weijerry982-oss/esp32-codex-voice-terminal/docs/hardware.md

模块	GPIO 分配（参考图）

I²S 麦克风 WS	GPIO4

I²S 麦克风 SCK	GPIO5

I²S 麦克风 SD	GPIO6

MAX98357A DIN	GPIO7

MAX98357A BCLK	GPIO15

MAX98357A LRC	GPIO16

OLED SDA	GPIO41

OLED SCL	GPIO42
# ESP32-S3 N16R8 开发板与外设

开发板目标为 ESP32-S3 N16R8，Arduino IDE 开发板型号暂定 `ESP32S3 Dev Module`。Flash、PSRAM、USB 与其他编译参数应根据实物和阶段 1 验证结果确认。

## 外设清单

- I²S 麦克风：待确认具体型号及供电/电平要求。
- MAX98357A I²S 功放与扬声器：待确认扬声器规格及供电。
- OLED：0.91 英寸，128×32，I²C；控制器型号待确认。
- 实体按键：用途包括明确任务的确认/取消交互，接线和去抖方式待验证。
- 状态 LED：颜色、有效电平及限流配置待验证。

## 引脚表（用户确认接线；实物电气待验证）

上方保留了仓库原有参考清单。下表反映用户确认的接线图；实际板卡连通性与模块电气参数仍待实物核对。确认最终接线后依项目规则不得擅自更改。

| 模块/信号 | ESP32-S3 GPIO | 状态 |
| --- | --- | --- |
| I²S 麦克风 WS | GPIO4 | 接线图已确认；2026-10-18 I2S 录音验证通过；具体型号仍待核对 |
| I²S 麦克风 SCK | GPIO5 | 接线图已确认；2026-10-18 I2S 录音验证通过；具体型号仍待核对 |
| I²S 麦克风 SD | GPIO6 | 接线图已确认；2026-10-18 I2S 录音验证通过；具体型号仍待核对 |
| MAX98357A DIN | GPIO7 | 接线图已确认；实物待核对 |
| MAX98357A BCLK | GPIO15 | 接线图已确认；实物待核对 |
| MAX98357A LRC | GPIO16 | 接线图已确认；实物待核对 |
| OLED SDA | GPIO41 | 接线图已确认；2026-10-18 I²C 通信成功（地址 0x3C）；显示已目视确认 |
| OLED SCK（I²C 时钟；通常称 SCL） | GPIO42 | 接线图已确认；2026-10-18 I²C 通信成功；显示已目视确认 |
| 按键 A | GPIO39 | 外接微动按钮到 GND；INPUT_PULLUP，低电平有效；30 ms 去抖；阶段 7 SEND（发送 ChatGPT 草稿） |
| 按键 B | GPIO40 | 外接微动按钮到 GND；INPUT_PULLUP，低电平有效；30 ms 去抖；阶段 7 CLEAR（清空 ChatGPT 草稿） |
| 状态 RGB LED | GPIO48 | XL-5050RGBC-WS2812B（WS2812B 兼容，24-bit GRB）；阶段 7：录音绿灯、SEND 绿闪 2 次、CLEAR 黄闪 2 次；用户目视确认 RGB 正常 |

麦克风采音与功放播放需分别验证，再进行组合运行验证。不得依据本文宣称硬件已运行成功。

## 确认按钮安全边界

实体确认按钮只能批准设备界面当前明确展示的待确认任务，不得无条件批准所有操作。Codex CLI 自身的权限检查和审批机制必须保留，不得关闭。

## 用户提供的接线图确认（当前接线基准）

用户确认附件中的接线图是本项目正确接线。此表描述用户的外接模块接法，不据此推断为小智仓库某个特定成品板型。图中音频引脚与 `bread-compact-wifi-lcd` 的 I²S simplex 音频配置一致；显示屏则是另接的 I²C 模块，不能套用该板型内置 SPI LCD 的引脚解释。

| 模块/端子 | 接线 | 备注 |
| --- | --- | --- |
| I²S 麦克风 WS | GPIO4 | 图示兼容 INMP441 / ICS43434，具体型号待实物确认 |
| I²S 麦克风 SCK | GPIO5 | I²S 时钟 |
| I²S 麦克风 SD | GPIO6 | 麦克风数据输出 |
| 麦克风 VDD / GND | 3V3 / GND | 图示如此；模块实际供电要求待核对 |
| 麦克风 L/R | 与 GND 短接 | 图示声道选择方式 |
| MAX98357A DIN | GPIO7 | 数字音频输入 |
| MAX98357A BCLK / LRC | GPIO15 / GPIO16 | 位时钟 / 左右时钟 |
| MAX98357A VIN（或 VCC）/ GND | 3V3 / GND | 图示如此；模块实际供电规格待核对 |
| MAX98357A SD | 图示与 VIN（3V3）短接 | 按图记录；模块实际引脚/要求待核对 |
| MAX98357A GAIN | 图示与 GND 短接 | 按图记录；增益设置待核对模块资料 |
| 扬声器正/负端 | MAX98357A 音频输出正/负端 | 按模块标识接线 |
| I²C 显示模块 SDA | GPIO41 | 图示 3V3、GND 供电 |
| I²C 显示模块时钟 | GPIO42 | 图中标为 `SCK`；I²C 时钟通常标为 `SCL`，需对照模块丝印确认 |

接线图确认不等于电气或功能已在实物测试。OLED 控制器、I²C 地址和电平兼容性已于 2026-10-18 通过 I²C 通信验证（见下文“OLED 模块资料与实测确认”）；屏幕实际显示内容已于同日目视确认。

## OLED 模块资料与实测确认（2026-10-18）

用户已提供并确认以下资料与接线：

- **控制器：** SSD1306（模块原理图 U1 标注 `M96-16-SSD1306`；与 SSD1306 数据手册对应）。
- **分辨率：** 128×32，0.91 英寸。
- **接口：** I²C；模块 SDA/SCL 各有 4.7K 上拉（原理图 R3/R4）。
- **模块接口（按原理图 J1，4 针）：** 1 VCC_IN、2 SCL、3 SDA、4 GND；实际以模块丝印为准。
- **供电：** 当前按用户接线使用 3V3/GND；模块 VCC_IN 经板载 U2（662K LDO）产生 VCC。模块允许的输入电压范围尚未从资料确认，未经确认不得改动接线。
- **I²C 地址：** 实测扫描到 **0x3C**（SSD1306 支持 0x3C/0x3D，由 SA0 决定）。
- **接线：** OLED SDA → GPIO41，OLED SCL → GPIO42，VCC → 3V3，GND → GND。
- **实测状态：** I²C 扫描、SSD1306 初始化、全屏点亮、清屏和测试画面传输均成功；2026-10-18 用户目视确认屏幕显示 `OLED OK` / `SSD1306` / `0x3C` + 闪烁块。

## 按键与状态灯（2026-10-18 用户确认）

| 模块/信号 | ESP32-S3 GPIO | 说明 |
| --- | --- | --- |
| 按键 A | GPIO39 | 外接微动按钮到 GND；`INPUT_PULLUP`，低电平有效；固件 30 ms 去抖 |
| 按键 B | GPIO40 | 外接微动按钮到 GND；`INPUT_PULLUP`，低电平有效；固件 30 ms 去抖 |
| 状态 RGB LED | GPIO8 | 三色 RGB，WS2812 兼容；使用 Arduino-ESP32 core 自带 `rgbLedWrite`（默认 GRB）；无需外部库 |

- 按键为测试输入，后续用于确认任务时必须遵守“只确认当前界面明确展示的一项任务”的安全边界。
- RGB LED 测试映射：GPIO39 按下=红，GPIO40 按下=蓝，双按=绿，松开=灭。
- **引脚确认（2026-10-18）：** 小智源码 `main/boards/bread-compact-wifi/config.h` 与实板一致：`BUILTIN_LED_GPIO=GPIO48`，按键 GPIO39/40，OLED SDA41/SCL42 128×32，麦克风 GPIO4/5/6，功放 GPIO7/15/16。此前使用的 GPIO8 来自 ESP32-C3 原理图，不是本 S3 板；改用 GPIO48 复测并通过，用户目视确认 RGB 自检和按键颜色正常。XL-5050RGBC-WS2812B 官方 VDD 3.5–5.5V，小智 demo 运行正常，说明实板供电正常。
- **驱动方式说明：** `主控资料/规格书.pdf` 第 18 页 5.2.1.7 的 LED PWM 控制器为 6 个独立通道、最高 14-bit 分辨率、可用 APB 时钟、支持 Light-sleep 和硬件渐变，适合分立 LED/PWM 调光；`XL-5050RGBC-WS2812B` 是单线可寻址 LED，需要 WS2812B 的 800 kbit/s NRZ 时序（RMT 或位翻转），不能按 3 路 PWM 驱动。该规格书是 ESP32-C3-MINI-1 v1.8，不等同于 ESP32-S3 N16R8 的完整引脚/外设资料。
- RGB 引脚以用户确认的 GPIO48 为准（小智 bread-compact-wifi 的 `BUILTIN_LED_GPIO`）；GPIO8 来自 ESP32-C3 原理图，不适用于本 S3 板。
- GPIO0/BOOT 作为运行期语音键（小智 bread-compact-wifi 的 BOOT 键）；复位/上电时不得按住，否则芯片会进入下载模式。

## I²S 麦克风实测（2026-10-18）

- **引脚：** WS=GPIO4、SCK=GPIO5、SD=GPIO6。
- **配置：** I2S 标准模式，16000 Hz，32-bit slot，mono，left slot；实测约 16,128 样本/秒。
- **结果：** 静音 RMS 约 2,300–2,700；说话/拍手 RMS 约 40k–174k、p-p 最高约 12.6M；连续 39 个 1 秒窗口稳定。
- **结论：** 录音数据链路、采样参数和稳定性已验证；具体麦克风型号（INMP441/ICS43434）仍待实物核对。

## MAX98357A 扬声器实测（2026-10-18）

- **引脚：** DIN=GPIO7、BCLK=GPIO15、LRC=GPIO16；VIN/GND=3V3/GND，SD 接 VIN，GAIN 接 GND。
- **配置：** I2S 标准模式，24000 Hz，16-bit，stereo；播放 440/660/880 Hz 各 1 秒 + 1 秒静音循环。
- **串口结果：** 音调序列日志循环正常（440→660→880→silence）。
- **听觉确认：** 2026-10-18 用户确认听到 440/660/880 Hz 对应音调；阶段 4 通过（音量主观可闻，未做定量测量）。
