weijerry982-oss/esp32-codex-voice-terminal/docs/主控资料/原理图.pdf

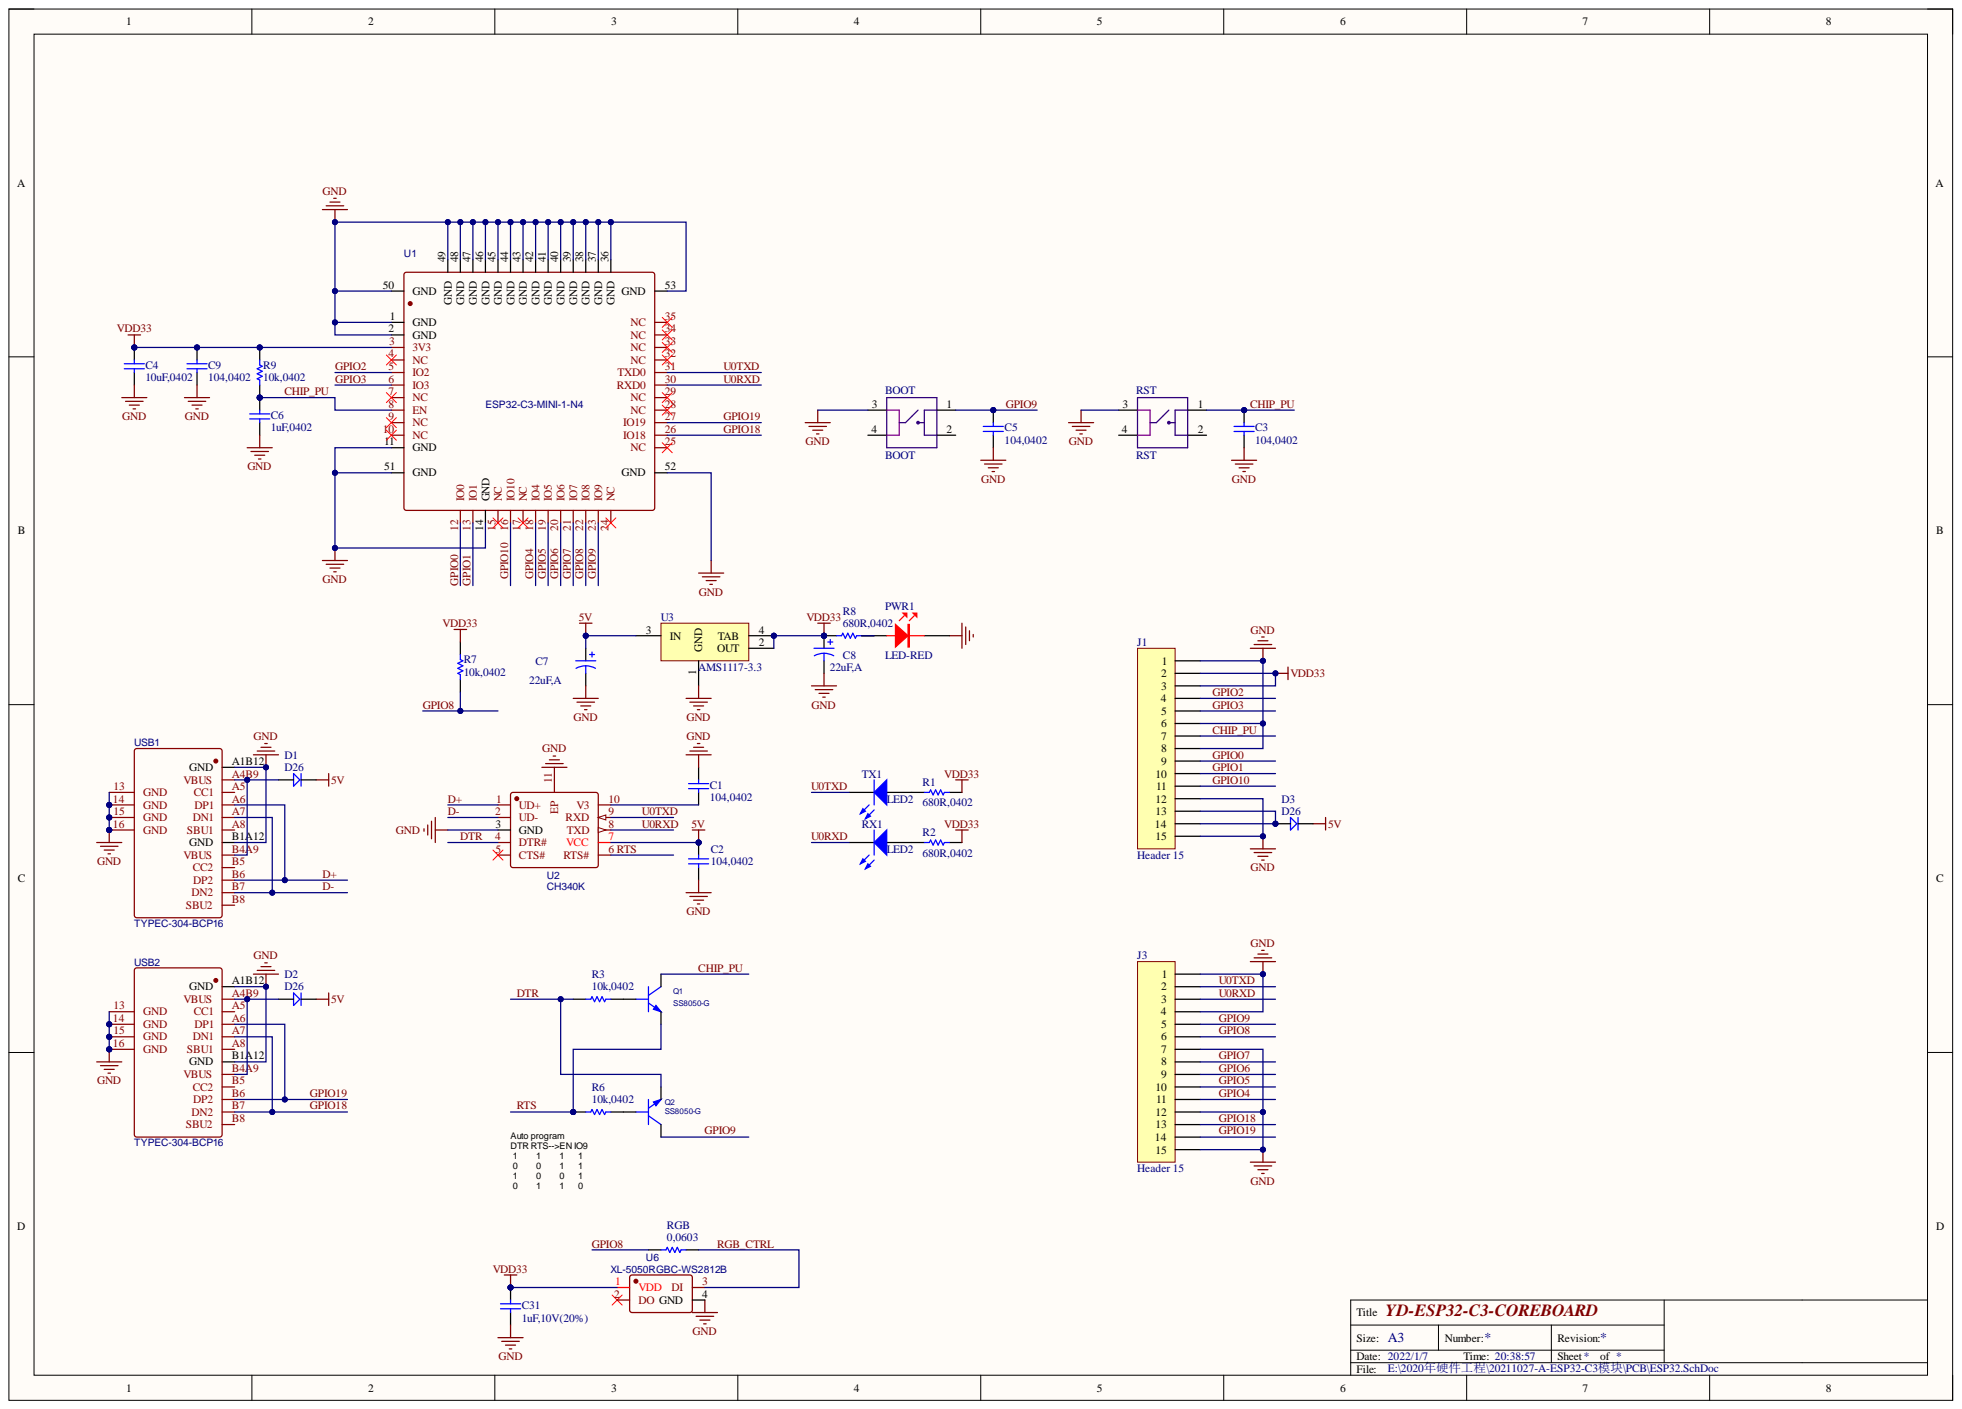
[picture p1: page 1]

GND 36 GND 37 GND 38 GND 39 GND 40 GND 41 GND 42 GND 43 GND 44 GND 45 GND 46 GND 47 GND 48 GND 49

U0TXD
U0RXD

GPIO7
GPIO6
GPIO5
GPIO4

GPIO18
GPIO19
