weijerry982-oss/esp32-codex-voice-terminal/docs/OLED/091寸OLED模块原理图_IIC接口-.pdf

# 0.91'' 128*32单色OLED驱动板

## Active Area 0.91''

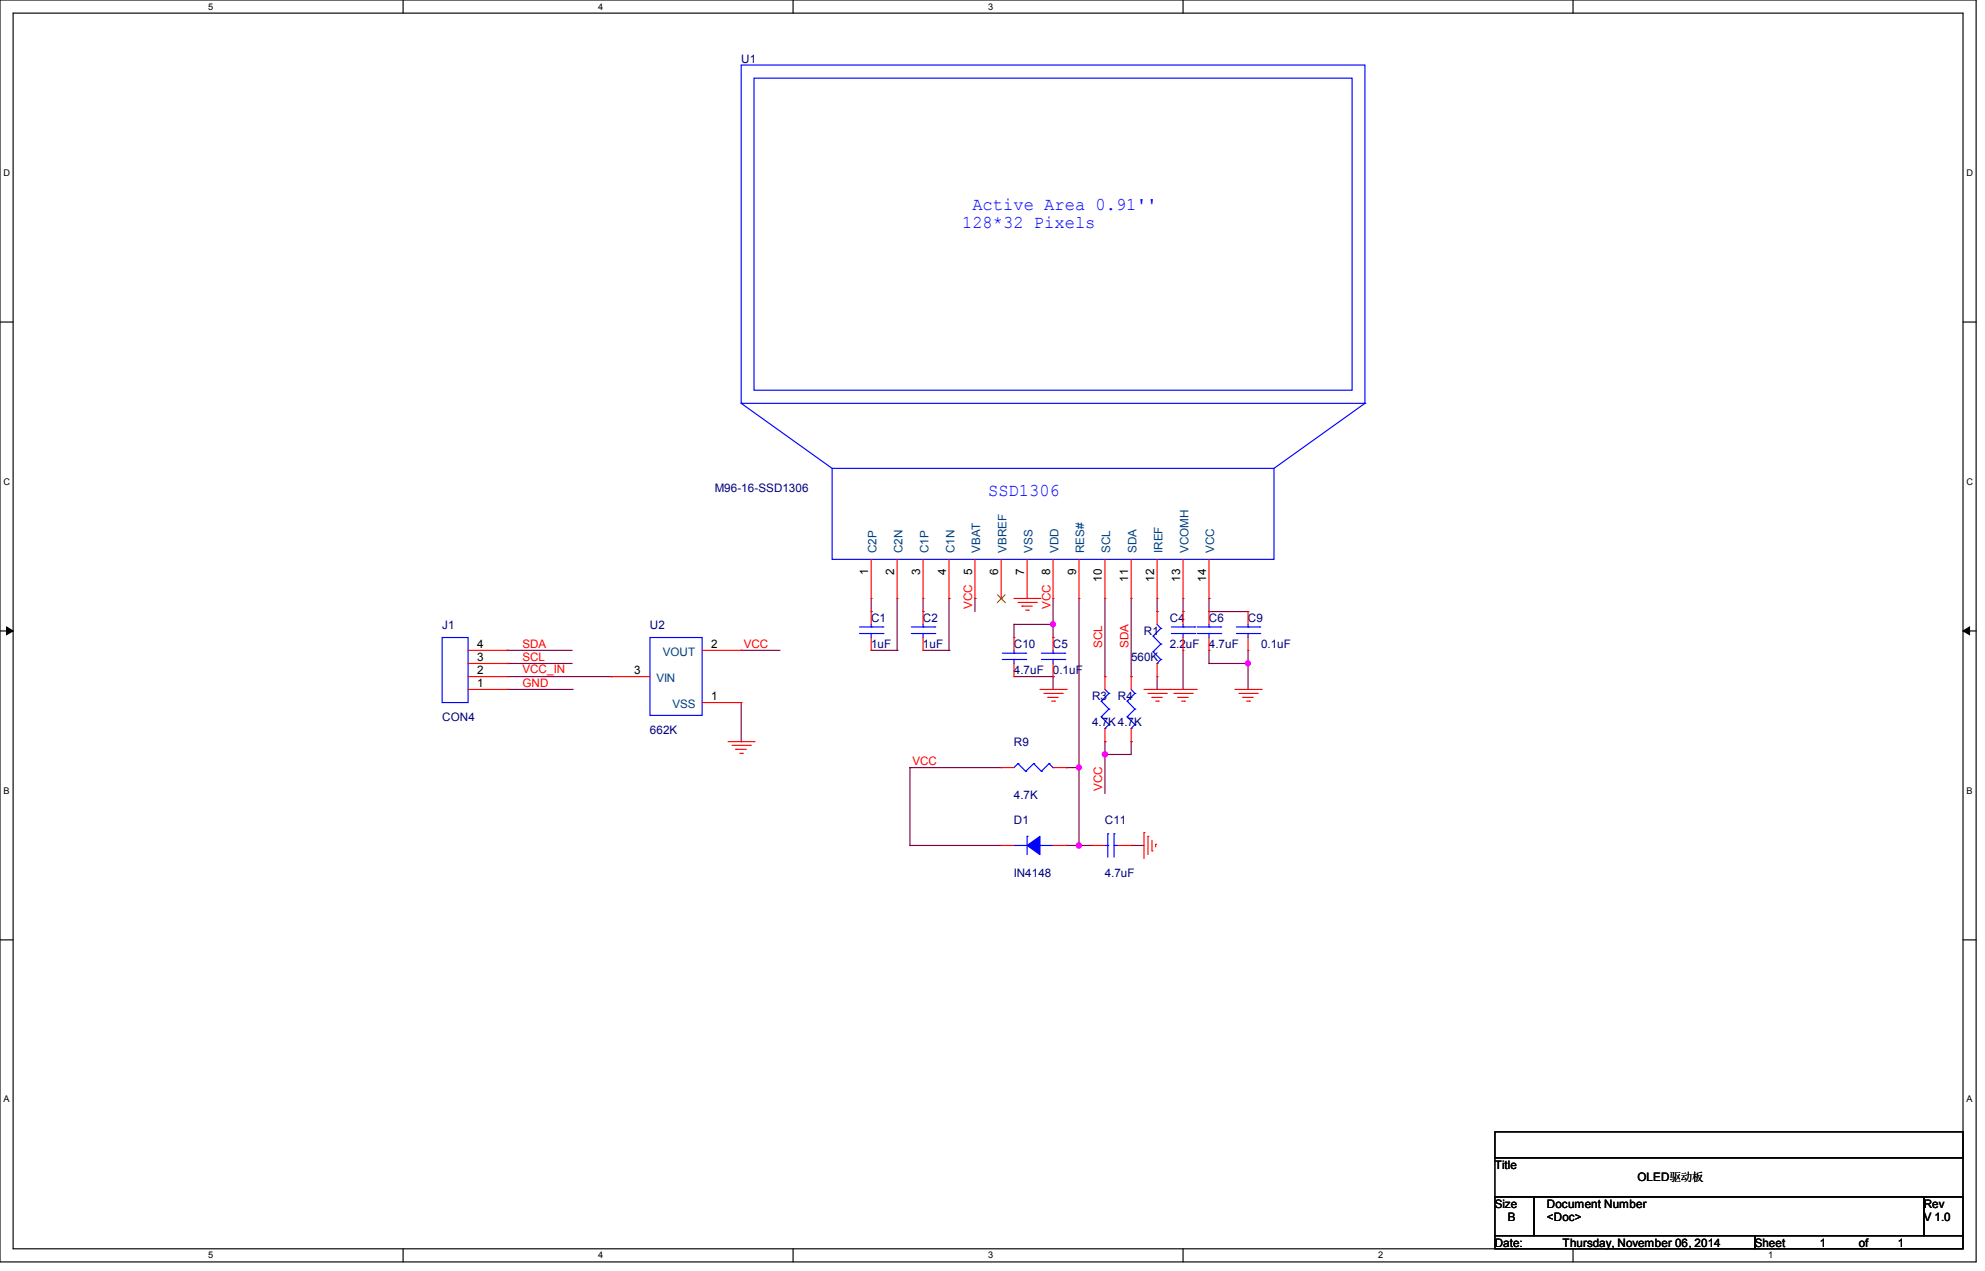
[picture p2: page 1]

邮箱：2355526548@qq.com
天猫店铺网址：https://telesky.tmall.com
