weijerry982-oss/esp32-codex-voice-terminal/firmware/esp32/stage7_task_confirm/record_countdown_bitmaps.h

#pragma once
#include <stdint.h>

// Generated from SimSun 12/18px by host/python/data/render_record_countdown.ps1.
// 128x32, page-major, 1 bit = lit pixel; index 0..20 seconds remaining.

const uint8_t kRecordCountdown0[512] = {
  0x00, 0x00, 0x00, 0x00, 0x00, 0x00, 0x00, 0x00, 0x00, 0x00, 0x00, 0x00, 0x00, 0x00, 0x00, 0x00,
  0x00, 0x00, 0x00, 0x00, 0x00, 0x00, 0x00, 0x00, 0x00, 0x00, 0x00, 0x00, 0x00, 0x00, 0x00, 0x00,
  0x00, 0x00, 0x00, 0x00, 0x00, 0x00, 0x00, 0x00, 0x00, 0x01, 0xF1, 0x01, 0x01, 0xFF, 0x21, 0x21,
  0x21, 0x21, 0x00, 0x00, 0x42, 0x22, 0xF2, 0x0E, 0x03, 0x42, 0x42, 0xFA, 0x42, 0x42, 0x02, 0x00,
  0x08, 0x28, 0x4A, 0x8A, 0x4A, 0xFA, 0x4A, 0x8A, 0x4F, 0x28, 0x08, 0x00, 0x08, 0xE9, 0xAB, 0xAD,
  0xA9, 0xA9, 0xA9, 0xAD, 0xAB, 0xE9, 0x08, 0x00, 0x00, 0x00, 0x00, 0x00, 0x00, 0x00, 0x00, 0x00,
  0x00, 0x00, 0x00, 0x00, 0x00, 0x00, 0x00, 0x00, 0x00, 0x00, 0x00, 0x00, 0x00, 0x00, 0x00, 0x00,
  0x00, 0x00, 0x00, 0x00, 0x00, 0x00, 0x00, 0x00, 0x00, 0x00, 0x00, 0x00, 0x00, 0x00, 0x00, 0x00,
  0x00, 0x00, 0x00, 0x00, 0x00, 0x00, 0x00, 0x00, 0x00, 0x00, 0x00, 0x00, 0x00, 0x00, 0x00, 0x00,
  0x00, 0x00, 0x00, 0x00, 0x00, 0x00, 0x00, 0x00, 0x00, 0x00, 0x00, 0x00, 0x00, 0x00, 0x00, 0x00,
  0x00, 0x00, 0x00, 0x00, 0x00, 0x00, 0x00, 0x00, 0x04, 0x04, 0x07, 0x04, 0x04, 0x07, 0x04, 0x04,
  0x04, 0x04, 0x04, 0x00, 0x00, 0x80, 0x87, 0x80, 0x04, 0x04, 0x04, 0x07, 0x44, 0x44, 0x44, 0xC0,
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
  kRecordCountdown8,
  kRecordCountdown9,
  kRecordCountdown10,
  kRecordCountdown11,
  kRecordCountdown12,
  kRecordCountdown13,
  kRecordCountdown14,
  kRecordCountdown15,
  kRecordCountdown16,
  kRecordCountdown17,
  kRecordCountdown18,
  kRecordCountdown19,
  kRecordCountdown20,
};
