weijerry982-oss/esp32-codex-voice-terminal/firmware/esp32/stage6_voice_loop/voice_config.example.h

#pragma once

// Copy this file to voice_config.h and set the Windows service URL.
// voice_config.h is excluded by .gitignore.
#define VOICE_SERVICE_URL "http://192.168.2.72:8765/api/v1/audio/utterance"
#define VOICE_KEY_PIN 0
