weijerry982-oss/esp32-codex-voice-terminal/(commit log)

2026-10-18 Initial commit: ESP32-Codex-Voice-Terminal stage 8 current state
2026-10-18 docs: add stage 8 to README
2026-10-18 feat: sleep OLED after 60s idle and blink green LED
2026-10-18 fix: first button press only wakes display
